TheRealBluesun/keeb4x4/docs/jlinkpins.png

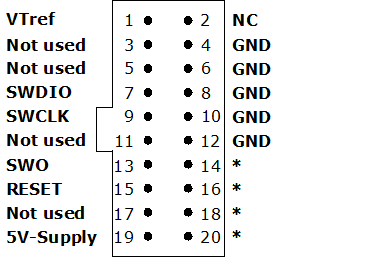
docs/jlinkpins.png
