TheRealBluesun/keeb4x4/fab/led_polarity_check.png

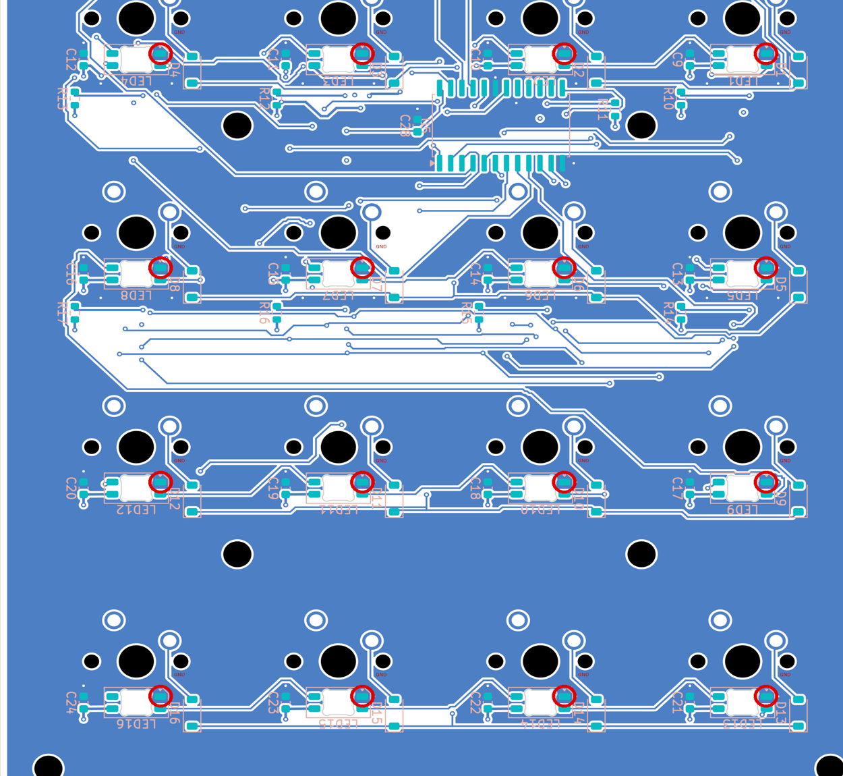
fab/led_polarity_check.png
