TheRealBluesun/keeb4x4/fab/keeb4x4_bom.csv

Comment | Designator | Footprint | LCSC Part # | Quantity
100nF | C1,C2,C3,C6,C7,C8,C9,C10,C11,C12,C13,C14,C15,C16,C17,C18,C19,C20,C21,C22,C23,C24,C28,C29 | C_0603_1608Metric | C14663 | 24
4.7uF | C4 | C_0603_1608Metric | C19666 | 1
1uF | C5,C25,C26 | C_0603_1608Metric | C15849 | 3
10uF | C27 | C_0805_2012Metric | C15850 | 1
1N4148W | D1,D2,D3,D4,D5,D6,D7,D8,D9,D10,D11,D12,D13,D14,D15,D16 | D_SOD-123 | C81598 | 16
USB_C_16P | J1 | USB_C_Receptacle_HRO_TYPE-C-31-M-12 | C165948 | 1
FH12-12S-0.5SH (ScreenKey FPC) | J4,J5,J6,J7,J8,J9,J10,J11,J12,J13,J14,J15 | Hirose_FH12-12S-0.5SH_1x12-1MP_P0.50mm_Horizontal | C88360 | 12
SK6812MINI-E | LED1,LED2,LED3,LED4,LED5,LED6,LED7,LED8,LED9,LED10,LED11,LED12,LED13,LED14,LED15,LED16 | LED_SK6812MINI-E_3.2x2.8mm_P1.5mm_ReverseMount | C5149201 | 16
AO3400A | Q1 | SOT-23 | C20917 | 1
5.1k | R1,R2 | R_0603_1608Metric | C23186 | 2
10k | R3 | R_0603_1608Metric | C25804 | 1
4.7k | R4,R5 | R_0603_1608Metric | C23162 | 2
100 | R6,R7,R8,R9,R10,R11,R12,R13,R14,R15,R16,R17 | R_0603_1608Metric | C22775 | 12
B3U-1000P tactile | SW18,SW19 | SW_SPST_B3U-1000P | C231329 | 2
STM32G431CBT6 | U1 | LQFP-48_7x7mm_P0.5mm | C529355 | 1
USBLC6-2SC6 | U2 | SOT-23-6 | C2687116 | 1
AP2112K-3.3 | U3 | SOT-23-5 | C51118 | 1
74AHCT1G125 | U4 | SOT-23-5 | C7484 | 1
74HC154 | U5 | SOIC-24W_7.5x15.4mm_P1.27mm | C2832236 | 1
W25Q128JVSIQ | U6 | SOIC-8_5.3x5.3mm_P1.27mm | C97521 | 1
