TheRealBluesun/keeb4x4/enclosure/exports/h3_fit_sample.step

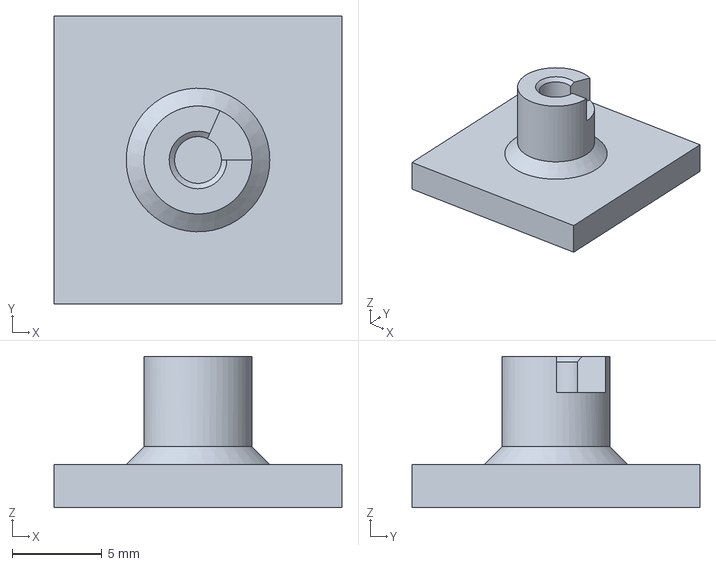
[picture p5: CAD file, 2026-10-24]
enclosure/exports/h3_fit_sample.step
16.0 x 16.0 x 8.40 mm
