TheRealBluesun/keeb4x4/enclosure/exports/corner_fit_sample.step

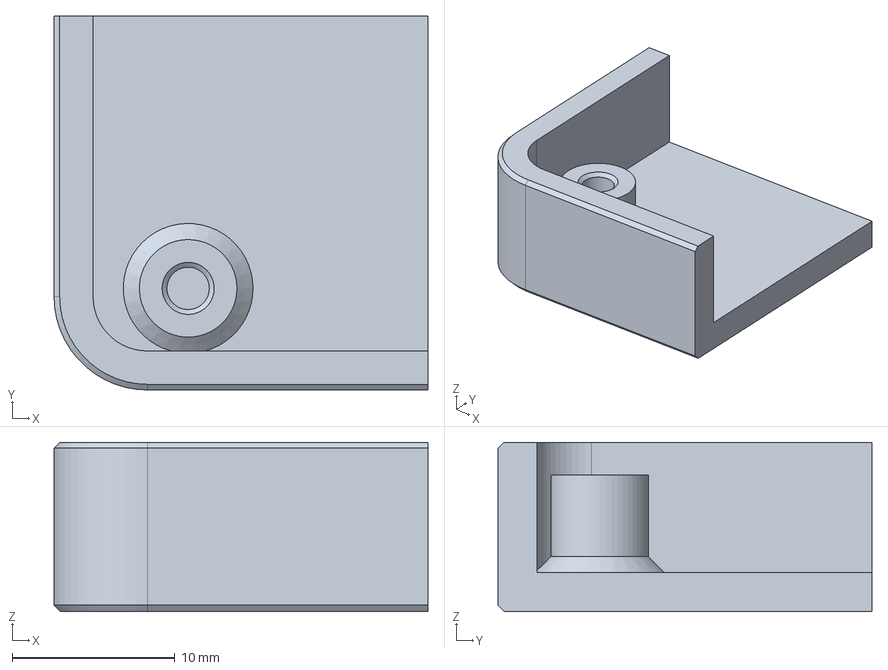
[picture p6: CAD file, 2026-10-24]
enclosure/exports/corner_fit_sample.step
23.0 x 23.0 x 10.4 mm
