TheRealBluesun/keeb4x4/enclosure/exports/keeb4x4_base.step

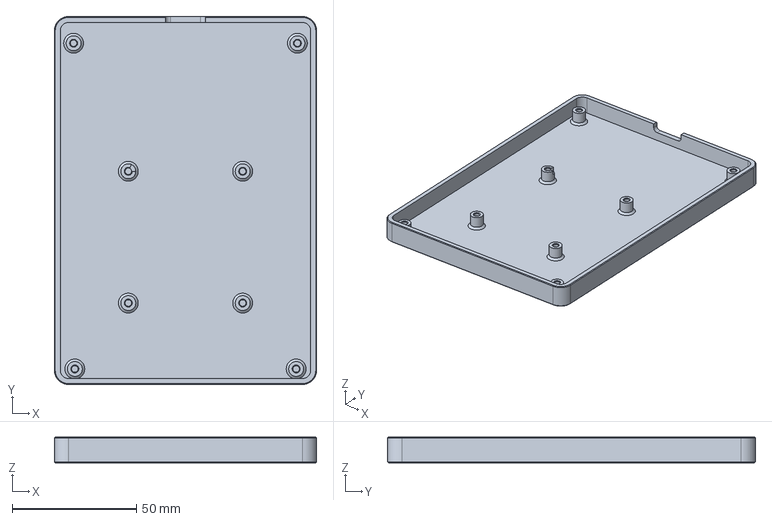
[picture p7: CAD file, 2026-10-24]
enclosure/exports/keeb4x4_base.step
105.5 x 148.0 x 10.4 mm
