TheRealBluesun/keeb4x4/(list of files, cad)

Other CAD files:
enclosure/exports/corner_fit_sample.stl
enclosure/exports/h3_fit_sample.stl
enclosure/exports/keeb4x4_base.stl
