TheRealBluesun/keeb4x4/fab/keeb4x4_schematic.pdf

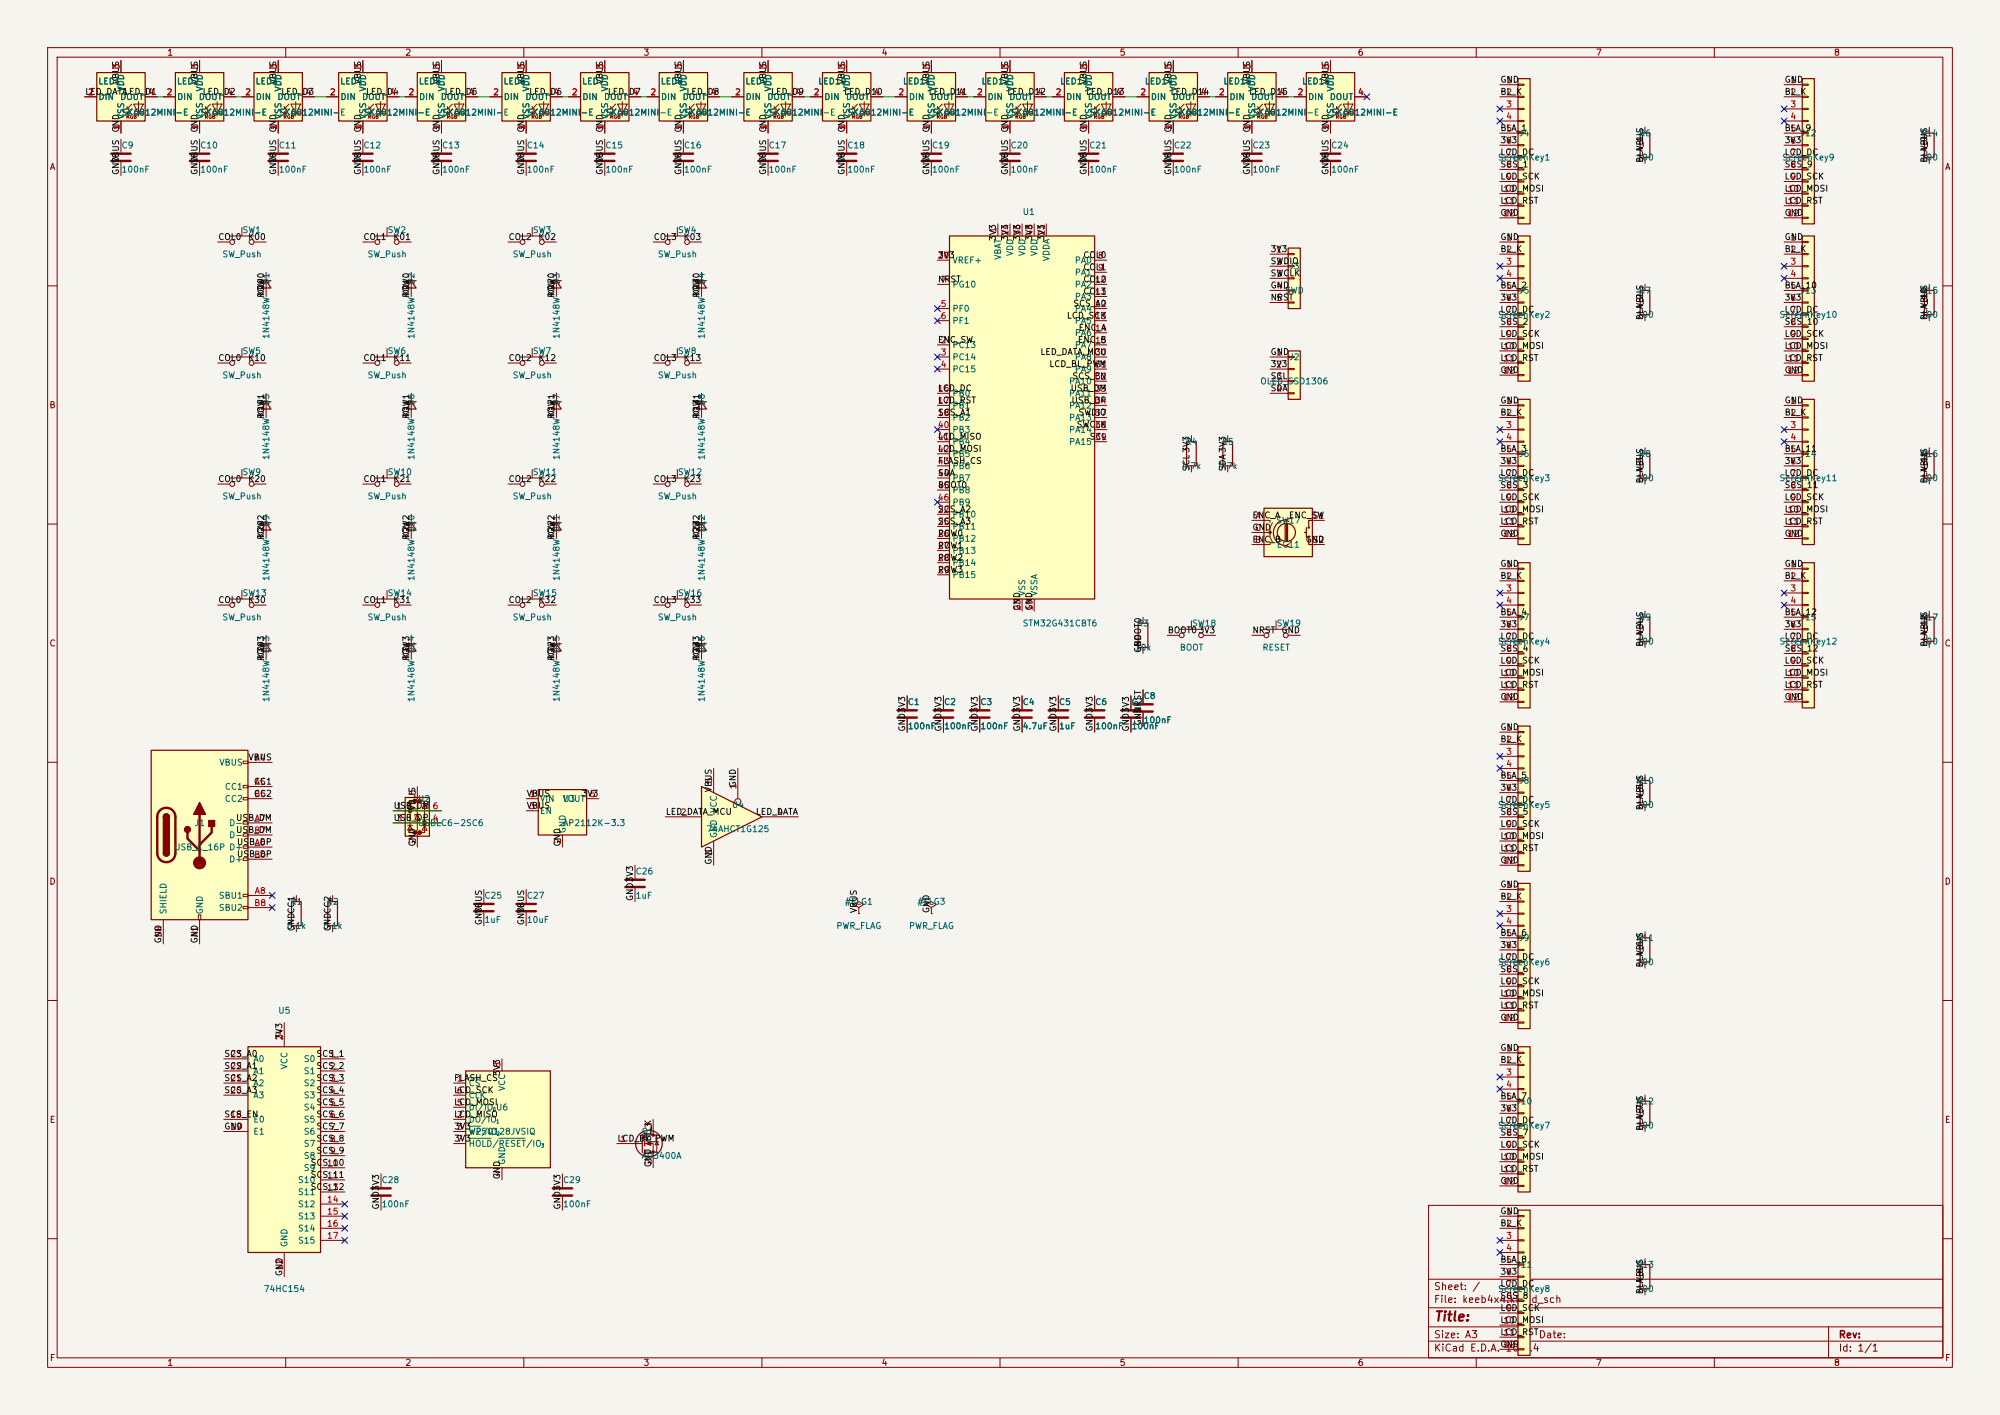
[picture p8: page 1]

LCD_RST LCD_MOSI GND GND 1 SCS_8 BL_K 2 3 4 BLA_8 5 6 | R13

Sheet: / 7 8 File: keeb4x4.kicad_sch LCD_SCK 9

Title: 10
11 Size: A3 | Rev: | F Date:
KiCad E.D.A. 10.0.4 GND 12 | | Id: 1/1
