TheRealBluesun/keeb4x4/enclosure/exports/dimensions.pdf

# KEEB 4x4 / screw-down base

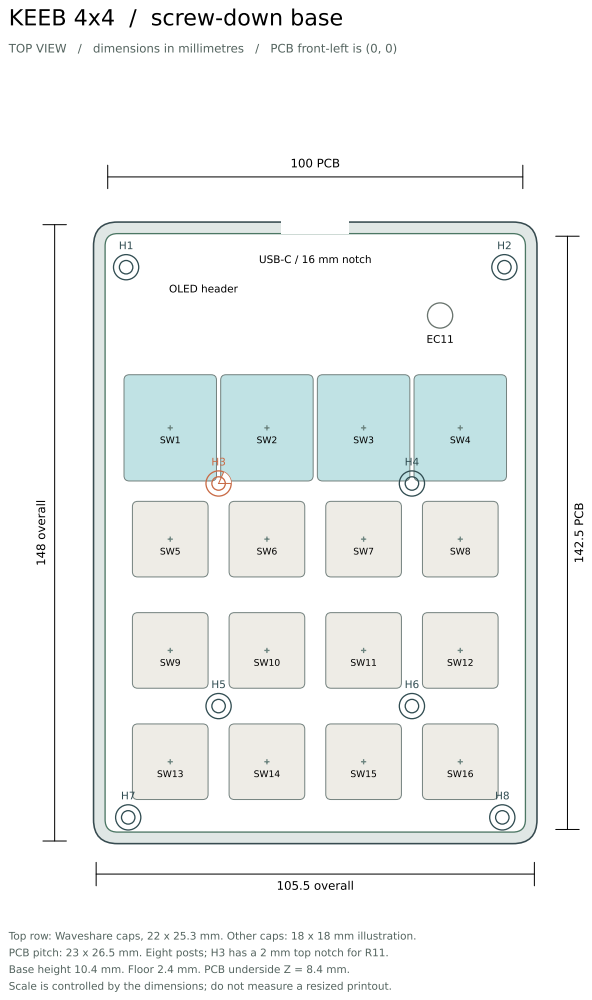
[picture p9: page 1]

TOP VIEW / dimensions in millimetres / PCB front-left is (0, 0)

Top row: Waveshare caps, 22 x 25.3 mm. Other caps: 18 x 18 mm illustration.
PCB pitch: 23 x 26.5 mm. Eight posts; H3 has a 2 mm top notch for R11.
Base height 10.4 mm. Floor 2.4 mm. PCB underside Z = 8.4 mm.
Scale is controlled by the dimensions; do not measure a resized printout.
