TheRealBluesun/keeb4x4/fab/keeb4x4_pcb.pdf

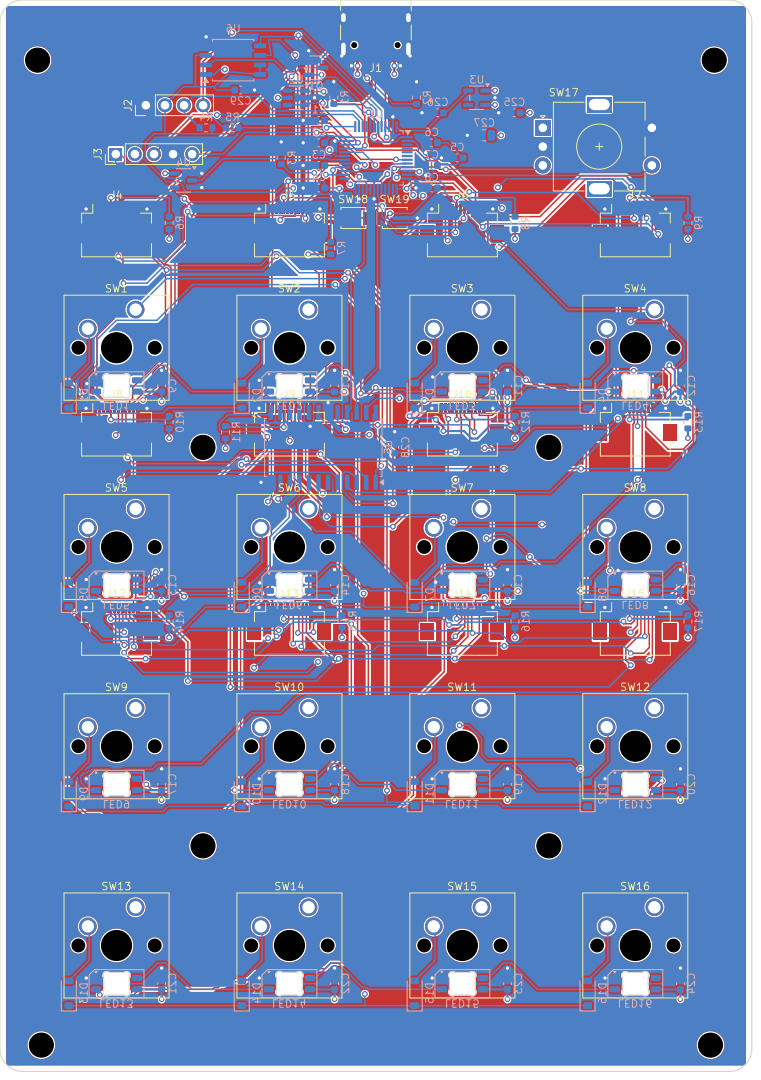
[picture p10: page 1]
