TheRealBluesun/keeb4x4/keeb4x4.kicad_pcb

## KiCad design keeb4x4.kicad_pcb (2026-10-24)

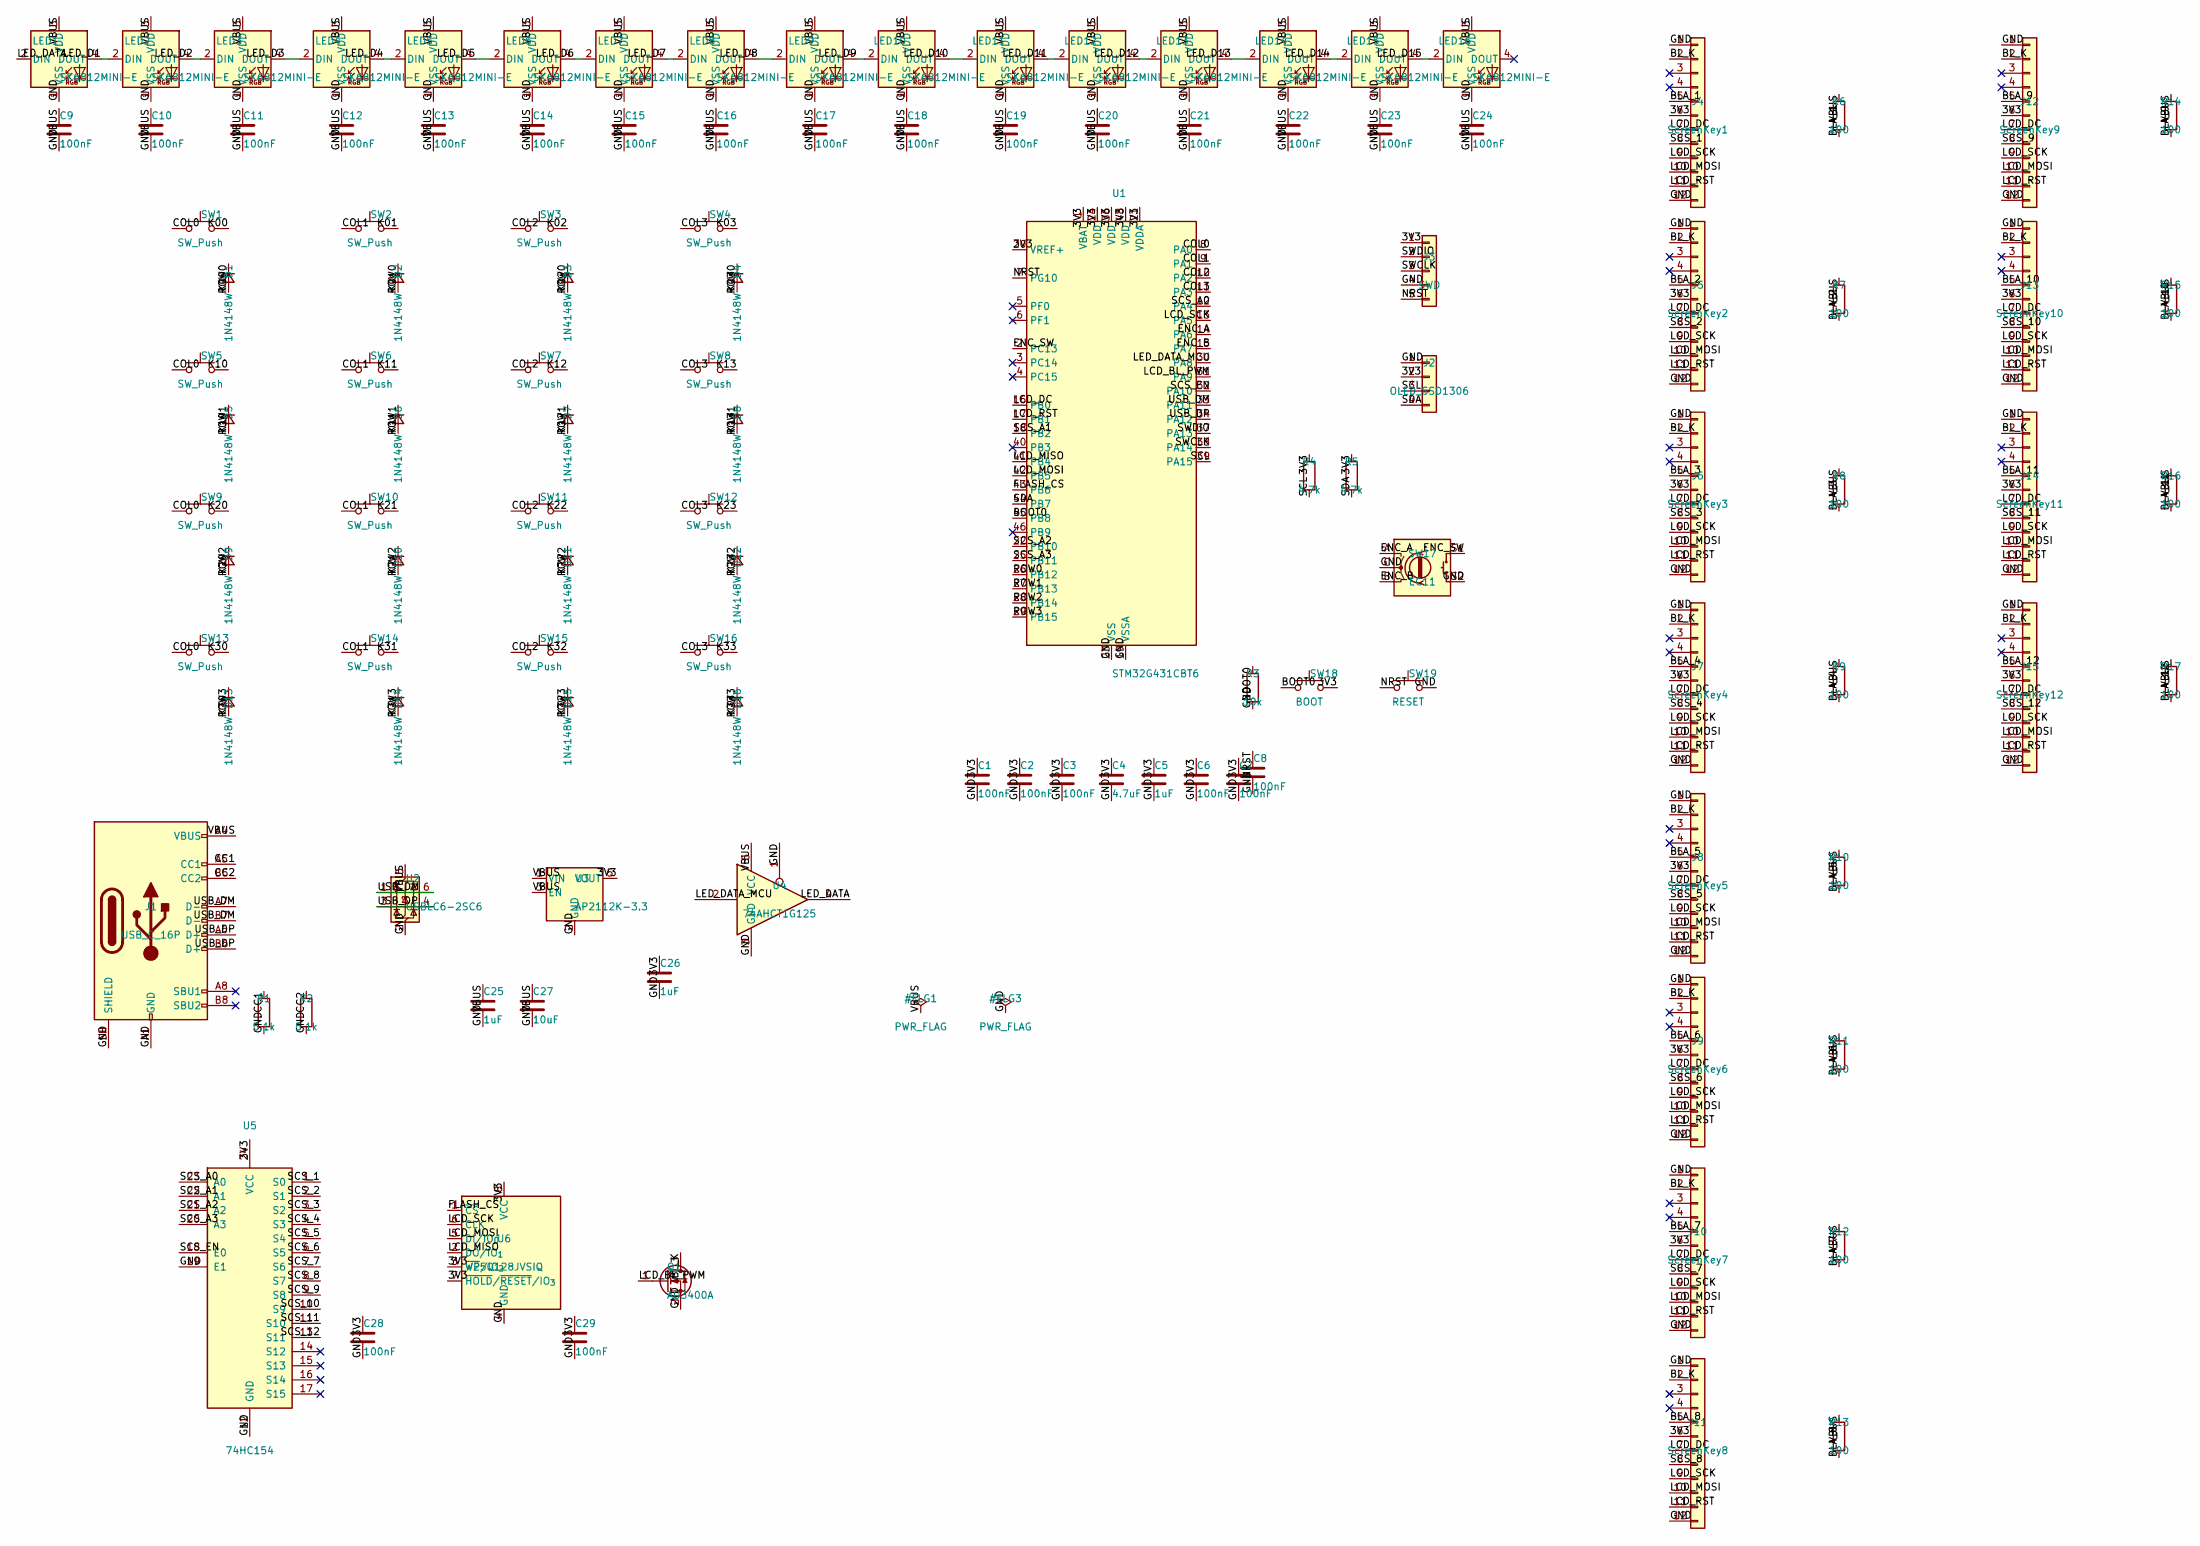
[picture p11: schematic keeb4x4.kicad_sch]

Parts:
C1, C2, C3, C6, C7, C8, C9, C10, C11, C12, C13, C14, C15, C16, C17, C18, C19, C20, C21, C22, C23, C24, C28, C29: 100nF; C_0603_1608Metric
C4: 4.7uF; C_0603_1608Metric
C5, C25, C26: 1uF; C_0603_1608Metric
C27: 10uF; C_0805_2012Metric
D1, D2, D3, D4, D5, D6, D7, D8, D9, D10, D11, D12, D13, D14, D15, D16: 1N4148W; D_SOD-123
J1: USB_C_16P; USB_C_Receptacle_HRO_TYPE-C-31-M-12
J2: OLED_SSD1306; PinHeader_1x04_P2.54mm_Vertical
J3: SWD; PinHeader_1x05_P2.54mm_Vertical
J4: ScreenKey1; Hirose_FH12-12S-0.5SH_1x12-1MP_P0.50mm_Horizontal
J5: ScreenKey2; Hirose_FH12-12S-0.5SH_1x12-1MP_P0.50mm_Horizontal
J6: ScreenKey3; Hirose_FH12-12S-0.5SH_1x12-1MP_P0.50mm_Horizontal
J7: ScreenKey4; Hirose_FH12-12S-0.5SH_1x12-1MP_P0.50mm_Horizontal
J8: ScreenKey5; Hirose_FH12-12S-0.5SH_1x12-1MP_P0.50mm_Horizontal
J9: ScreenKey6; Hirose_FH12-12S-0.5SH_1x12-1MP_P0.50mm_Horizontal
J10: ScreenKey7; Hirose_FH12-12S-0.5SH_1x12-1MP_P0.50mm_Horizontal
J11: ScreenKey8; Hirose_FH12-12S-0.5SH_1x12-1MP_P0.50mm_Horizontal
J12: ScreenKey9; Hirose_FH12-12S-0.5SH_1x12-1MP_P0.50mm_Horizontal
J13: ScreenKey10; Hirose_FH12-12S-0.5SH_1x12-1MP_P0.50mm_Horizontal
J14: ScreenKey11; Hirose_FH12-12S-0.5SH_1x12-1MP_P0.50mm_Horizontal
J15: ScreenKey12; Hirose_FH12-12S-0.5SH_1x12-1MP_P0.50mm_Horizontal
LED1, LED2, LED3, LED4, LED5, LED6, LED7, LED8, LED9, LED10, LED11, LED12, LED13, LED14, LED15, LED16: SK6812MINI-E; LED_SK6812MINI-E_3.2x2.8mm_P1.5mm_ReverseMount
Q1: AO3400A; SOT-23
R1, R2: 5.1k; R_0603_1608Metric
R3: 10k; R_0603_1608Metric
R4, R5: 4.7k; R_0603_1608Metric
R6, R7, R8, R9, R10, R11, R12, R13, R14, R15, R16, R17: 100; R_0603_1608Metric
SW1, SW2, SW3, SW4, SW5, SW6, SW7, SW8, SW9, SW10, SW11, SW12, SW13, SW14, SW15, SW16: SW_Push; SW_Cherry_MX_1.00u_PCB
SW17: EC11; RotaryEncoder_Alps_EC11E-Switch_Vertical_H20mm
SW18: BOOT; SW_SPST_B3U-1000P
SW19: RESET; SW_SPST_B3U-1000P
U1: STM32G431CBT6; LQFP-48_7x7mm_P0.5mm
U2: USBLC6-2SC6; SOT-23-6
U3: AP2112K-3.3; SOT-23-5
U4: 74AHCT1G125; SOT-23-5
U5: 74HC154; SOIC-24W_7.5x15.4mm_P1.27mm
U6: W25Q128JVSIQ; SOIC-8_5.3x5.3mm_P1.27mm

Connections:
3V3: C1.1, C2.1, C3.1, C4.1, C5.1, C6.1, C7.1, C26.1, C28.1, C29.1, J2.2, J3.1, J4.6, J5.6, J6.6, J7.6, J8.6, J9.6, J10.6, J11.6, J12.6, J13.6, J14.6, J15.6, R4.1, R5.1, SW18.2, U1.1 (VBAT), U1.20 (VREF+), U1.21 (VDDA), U1.24 (VDD), U1.36 (VDD), U1.48 (VDD), U3.5 (VOUT), U5.24 (VCC), U6.3 (~WP/IO_{2}), U6.7 (~HOLD/~RESET/IO_{3}), U6.8 (VCC)
BLA_1: J4.5, R6.2
BLA_2: J5.5, R7.2
BLA_3: J6.5, R8.2
BLA_4: J7.5, R9.2
BLA_5: J8.5, R10.2
BLA_6: J9.5, R11.2
BLA_7: J10.5, R12.2
BLA_8: J11.5, R13.2
BLA_9: J12.5, R14.2
BLA_10: J13.5, R15.2
BLA_11: J14.5, R16.2
BLA_12: J15.5, R17.2
BL_K: J4.2, J5.2, J6.2, J7.2, J8.2, J9.2, J10.2, J11.2, J12.2, J13.2, J14.2, J15.2, Q1.3 (D)
BOOT0: R3.1, SW18.1, U1.45 (PB8)
CC1: J1.A5 (CC1), R1.1
CC2: J1.B5 (CC2), R2.1
COL0: SW1.1, SW5.1, SW9.1, SW13.1, U1.8 (PA0)
COL1: SW2.1, SW6.1, SW10.1, SW14.1, U1.9 (PA1)
COL2: SW3.1, SW7.1, SW11.1, SW15.1, U1.10 (PA2)
COL3: SW4.1, SW8.1, SW12.1, SW16.1, U1.11 (PA3)
ENC_A: SW17.A, U1.14 (PA6)
ENC_B: SW17.B, U1.15 (PA7)
ENC_SW: SW17.S1, U1.2 (PC13)
FLASH_CS: U1.43 (PB6), U6.1 (~CS)
GND: C1.2, C2.2, C3.2, C4.2, C5.2, C6.2, C7.2, C8.2, C9.2, C10.2, C11.2, C12.2, C13.2, C14.2, C15.2, C16.2, C17.2, C18.2, C19.2, C20.2, C21.2, C22.2, C23.2, C24.2, C25.2, C26.2, C27.2, C28.2, C29.2, J1.A1 (GND), J1.A12 (GND), J1.B1 (GND), J1.B12 (GND), J1.SH (SHIELD), J2.1, J3.4, J4.1, J4.12, J5.1, J5.12, J6.1, J6.12, J7.1, J7.12, J8.1, J8.12, J9.1, J9.12, J10.1, J10.12, J11.1, J11.12, J12.1, J12.12, J13.1, J13.12, J14.1, J14.12, J15.1, J15.12, LED1.1 (VSS), LED2.1 (VSS), LED3.1 (VSS), LED4.1 (VSS), LED5.1 (VSS), LED6.1 (VSS), LED7.1 (VSS), LED8.1 (VSS), LED9.1 (VSS), LED10.1 (VSS), LED11.1 (VSS), LED12.1 (VSS), LED13.1 (VSS), LED14.1 (VSS), LED15.1 (VSS), LED16.1 (VSS), Q1.2 (S), R1.2, R2.2, R3.2, SW17.C, SW17.S2, SW19.2, U1.19 (VSSA), U1.23 (VSS), U1.35 (VSS), U1.47 (VSS), U2.2 (GND), U3.2 (GND), U4.1, U4.3 (GND), U5.12 (GND), U5.19 (E1), U6.4 (GND)
K00: D1.2 (A), SW1.2
K01: D2.2 (A), SW2.2
K02: D3.2 (A), SW3.2
K03: D4.2 (A), SW4.2
K10: D5.2 (A), SW5.2
K11: D6.2 (A), SW6.2
K12: D7.2 (A), SW7.2
K13: D8.2 (A), SW8.2
K20: D9.2 (A), SW9.2
K21: D10.2 (A), SW10.2
K22: D11.2 (A), SW11.2
K23: D12.2 (A), SW12.2
K30: D13.2 (A), SW13.2
K31: D14.2 (A), SW14.2
K32: D15.2 (A), SW15.2
K33: D16.2 (A), SW16.2
LCD_BL_PWM: Q1.1 (G), U1.31 (PA9)
LCD_DC: J4.7, J5.7, J6.7, J7.7, J8.7, J9.7, J10.7, J11.7, J12.7, J13.7, J14.7, J15.7, U1.16 (PB0)
LCD_MISO: U1.41 (PB4), U6.2 (DO/IO_{1})
LCD_MOSI: J4.10, J5.10, J6.10, J7.10, J8.10, J9.10, J10.10, J11.10, J12.10, J13.10, J14.10, J15.10, U1.42 (PB5), U6.5 (DI/IO_{0})
LCD_RST: J4.11, J5.11, J6.11, J7.11, J8.11, J9.11, J10.11, J11.11, J12.11, J13.11, J14.11, J15.11, U1.17 (PB1)
LCD_SCK: J4.9, J5.9, J6.9, J7.9, J8.9, J9.9, J10.9, J11.9, J12.9, J13.9, J14.9, J15.9, U1.13 (PA5), U6.6 (CLK)
LED_D1: LED1.4 (DOUT), LED2.2 (DIN)
LED_D2: LED2.4 (DOUT), LED3.2 (DIN)
LED_D3: LED3.4 (DOUT), LED4.2 (DIN)
LED_D4: LED4.4 (DOUT), LED5.2 (DIN)
LED_D5: LED5.4 (DOUT), LED6.2 (DIN)
LED_D6: LED6.4 (DOUT), LED7.2 (DIN)
LED_D7: LED7.4 (DOUT), LED8.2 (DIN)
LED_D8: LED8.4 (DOUT), LED9.2 (DIN)
LED_D9: LED9.4 (DOUT), LED10.2 (DIN)
LED_D10: LED10.4 (DOUT), LED11.2 (DIN)
LED_D11: LED11.4 (DOUT), LED12.2 (DIN)
LED_D12: LED12.4 (DOUT), LED13.2 (DIN)
LED_D13: LED13.4 (DOUT), LED14.2 (DIN)
LED_D14: LED14.4 (DOUT), LED15.2 (DIN)
LED_D15: LED15.4 (DOUT), LED16.2 (DIN)
LED_DATA: LED1.2 (DIN), U4.4
LED_DATA_MCU: U1.30 (PA8), U4.2
NRST: C8.1, J3.5, SW19.1, U1.7 (PG10)
ROW0: D1.1 (K), D2.1 (K), D3.1 (K), D4.1 (K), U1.26 (PB12)
ROW1: D5.1 (K), D6.1 (K), D7.1 (K), D8.1 (K), U1.27 (PB13)
ROW2: D9.1 (K), D10.1 (K), D11.1 (K), D12.1 (K), U1.28 (PB14)
ROW3: D13.1 (K), D14.1 (K), D15.1 (K), D16.1 (K), U1.29 (PB15)
SCL: J2.3, R4.2, U1.39 (PA15)
SCS_1: J4.8, U5.1 (S0)
SCS_2: J5.8, U5.2 (S1)
SCS_3: J6.8, U5.3 (S2)
SCS_4: J7.8, U5.4 (S3)
SCS_5: J8.8, U5.5 (S4)
SCS_6: J9.8, U5.6 (S5)
SCS_7: J10.8, U5.7 (S6)
SCS_8: J11.8, U5.8 (S7)
SCS_9: J12.8, U5.9 (S8)
SCS_10: J13.8, U5.10 (S9)
SCS_11: J14.8, U5.11 (S10)
SCS_12: J15.8, U5.13 (S11)
SCS_13: U5.14 (S12)
SCS_14: U5.15 (S13)
SCS_15: U5.16 (S14)
SCS_16: U5.17 (S15)
SCS_A0: U1.12 (PA4), U5.23 (A0)
SCS_A1: U1.18 (PB2), U5.22 (A1)
SCS_A2: U1.22 (PB10), U5.21 (A2)
SCS_A3: U1.25 (PB11), U5.20 (A3)
SCS_EN: U1.32 (PA10), U5.18 (E0)
SDA: J2.4, R5.2, U1.44 (PB7)
SWCLK: J3.3, U1.38 (PA14)
SWDIO: J3.2, U1.37 (PA13)
USB_DM: J1.A7 (D-), J1.B7 (D-), U1.33 (PA11), U2.1 (I/O1), U2.6 (I/O1)
USB_DP: J1.A6 (D+), J1.B6 (D+), U1.34 (PA12), U2.3 (I/O2), U2.4 (I/O2)
VBUS: C9.1, C10.1, C11.1, C12.1, C13.1, C14.1, C15.1, C16.1, C17.1, C18.1, C19.1, C20.1, C21.1, C22.1, C23.1, C24.1, C25.1, C27.1, J1.A4 (VBUS), J1.A9 (VBUS), J1.B4 (VBUS), J1.B9 (VBUS), LED1.3 (VDD), LED2.3 (VDD), LED3.3 (VDD), LED4.3 (VDD), LED5.3 (VDD), LED6.3 (VDD), LED7.3 (VDD), LED8.3 (VDD), LED9.3 (VDD), LED10.3 (VDD), LED11.3 (VDD), LED12.3 (VDD), LED13.3 (VDD), LED14.3 (VDD), LED15.3 (VDD), LED16.3 (VDD), R6.1, R7.1, R8.1, R9.1, R10.1, R11.1, R12.1, R13.1, R14.1, R15.1, R16.1, R17.1, U2.5 (VBUS), U3.1 (VIN), U3.3 (EN), U4.5 (VCC)

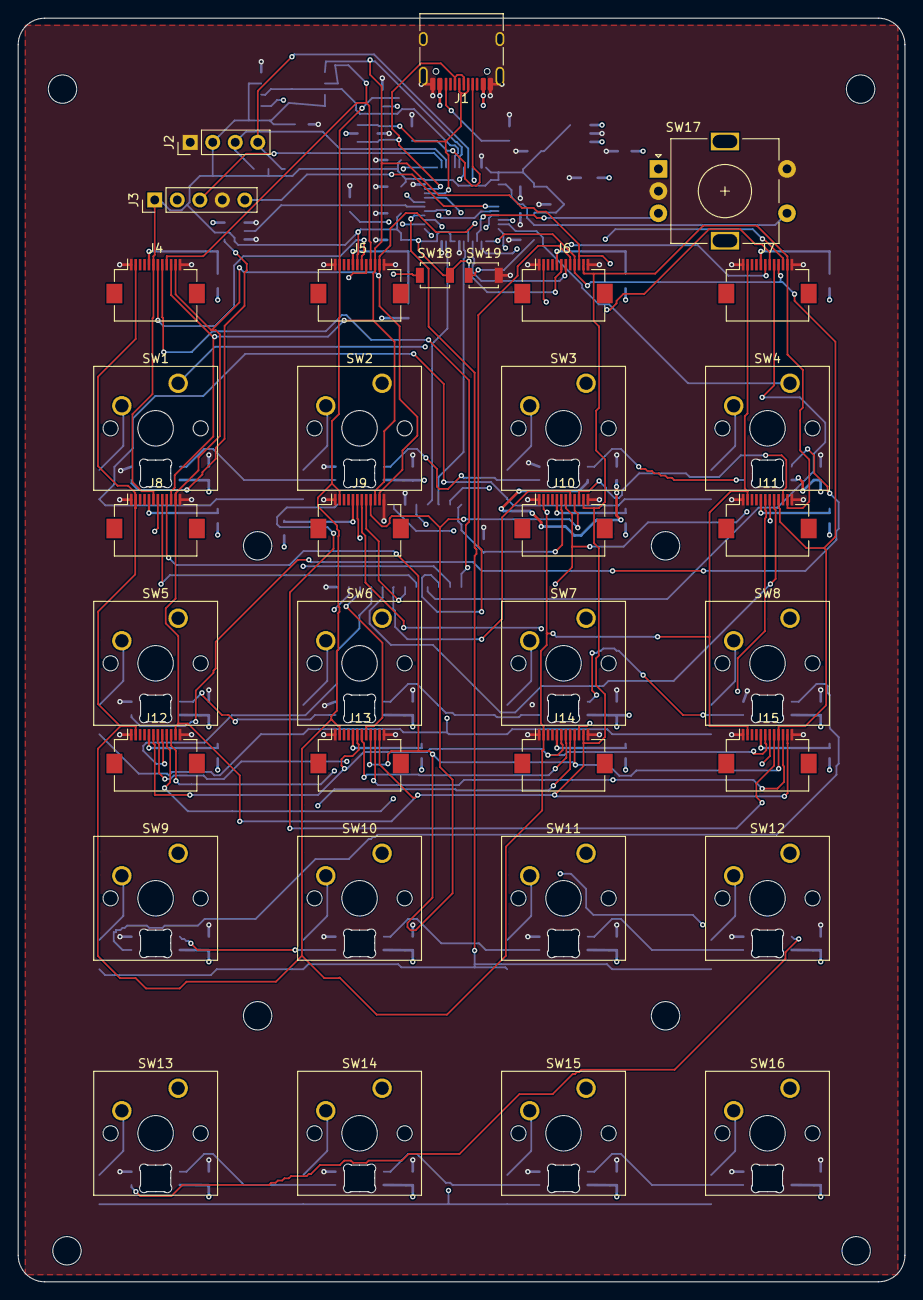
[picture p12: board keeb4x4.kicad_pcb from above]

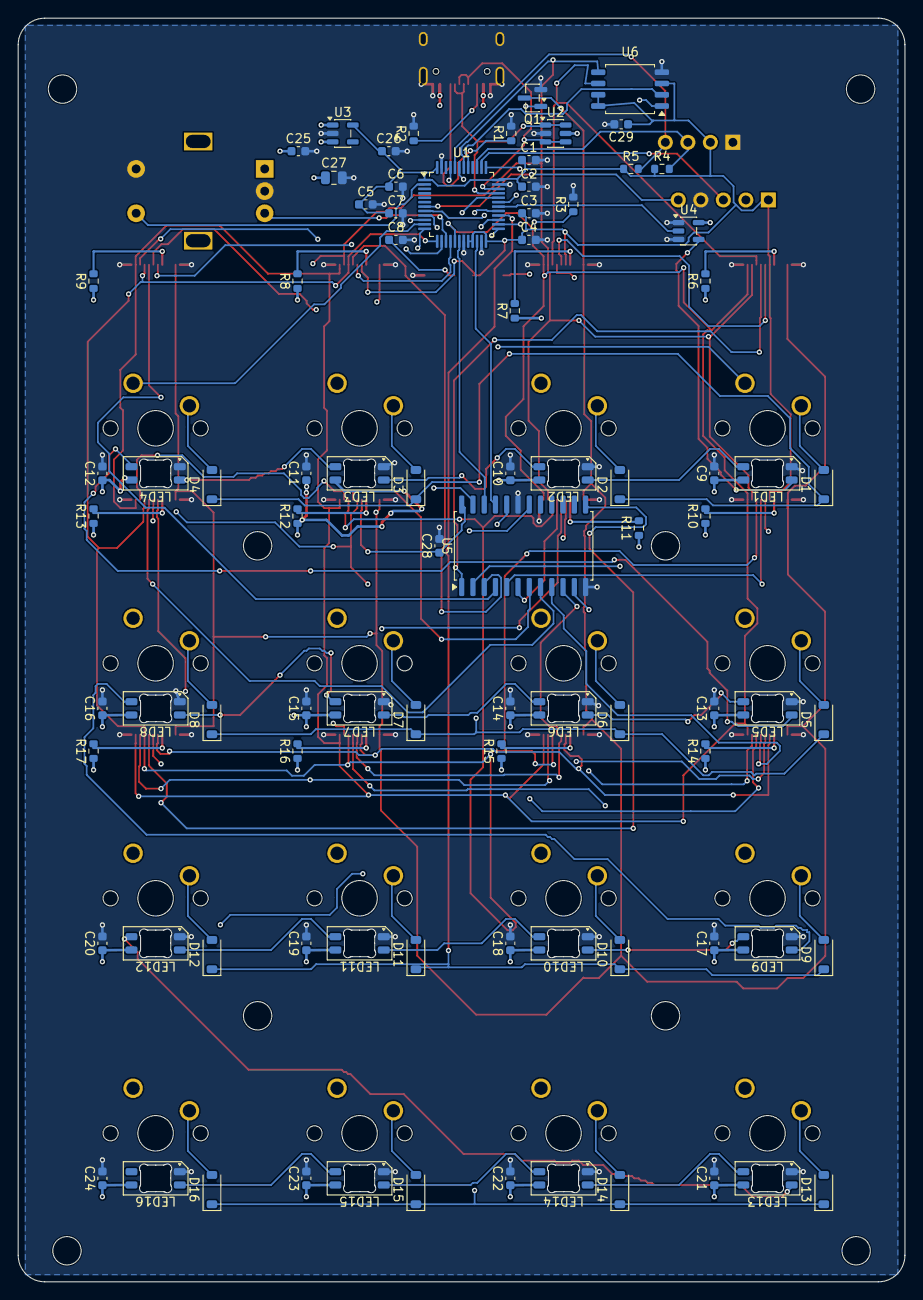
[picture p13: board keeb4x4.kicad_pcb from below]

Board: 4 copper layers, 100.0 x 142.5 mm, 127 parts (85 on the bottom side), 94 nets.

Other parts of the board:
H1, H2, H3, H4, H5, H6, H7, H8: MountingHole_3.2mm_M3
